byronin/Pico_Sumo_Robot/README.md

# Mini Sumo Robot with Raspberry Pi Pico 

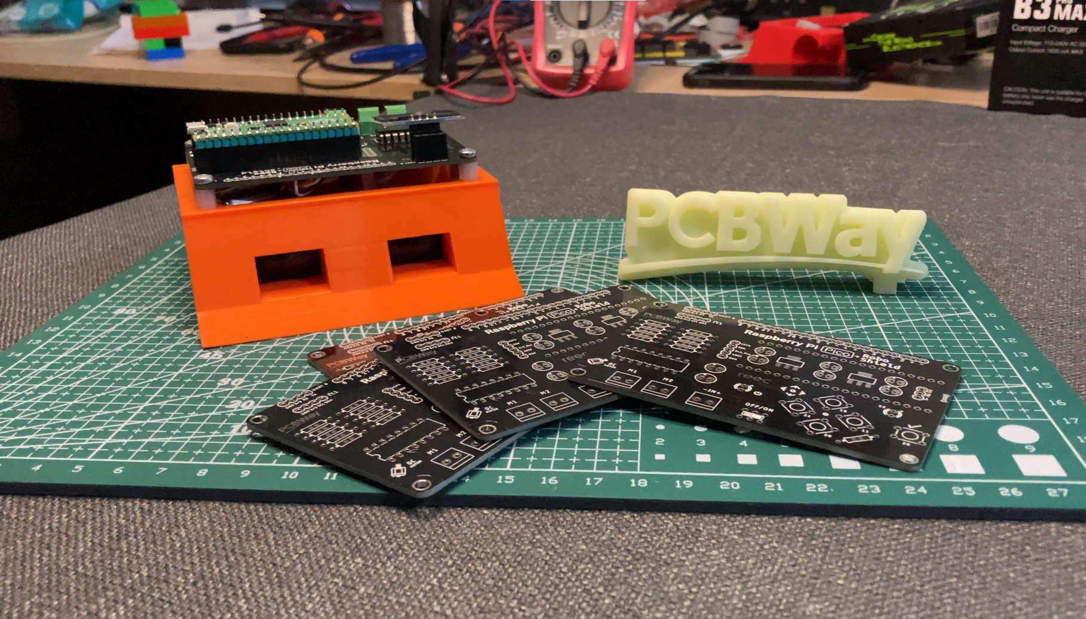
[picture p1: Hardware/Sumo2.png]


Actually, the goal of this project was not to build a mini sumo robot, but to create a robot control board that can be used with Raspberry Pi Pico. By making a mini sumo robot, I demonstrated a project that can be done with the control board. I made a small addition to the design so that everyone can easily solder the board in the workshop by choosing the preferred component shape. You can quickly and professionally manufacture this board via PCBWay.com. You can follow the necessary directions for the project below.
## Sponsor
(https://www.pcbway.com/project/shareproject/LoRa_Module_for_Raspberry_Pi_Arduino_ESP8266_Testing_LoRa_under_sea_83c3da00.html)
#### Thanks to PCBWay for handling PCB production.
<a href="https://www.pcbway.com/project/shareproject/Raspberry_Pi_Pico_Robot_Controller_Mini_Sumo_Robot_a2ead701.html">PCB from PCBWay</a>

  ## Schematic
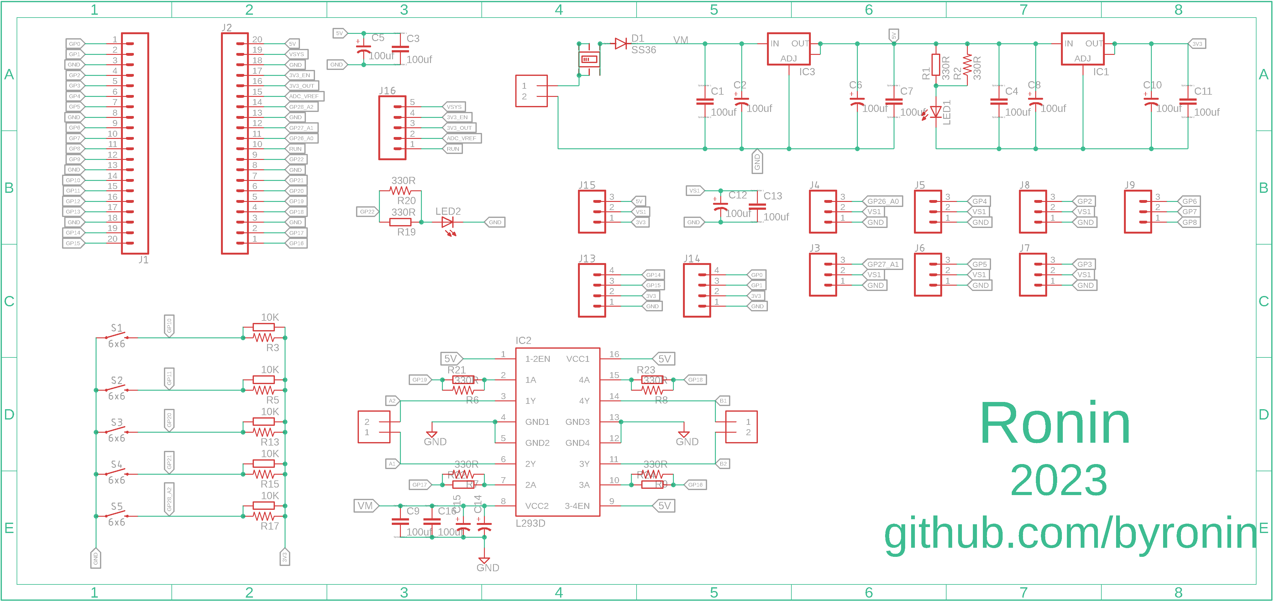
[picture p2: Hardware/Schematic.png]


## Hardware & BOM
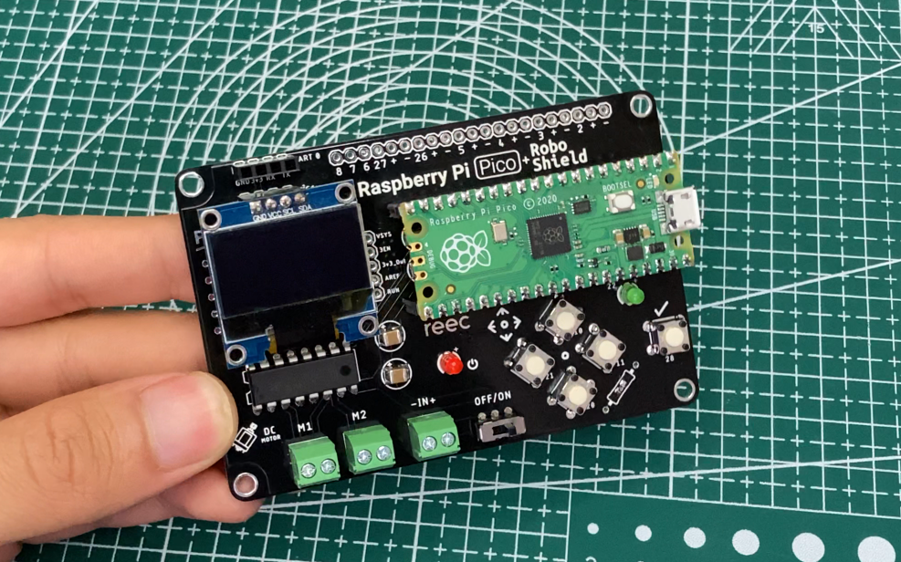
[picture p3: Hardware/Board1.png]

 This PCB Desing with Eagle PCB Desing with Eagle (https://www.autodesk.com/products/eagle/free-download "This PCB Desing with Eagle ") 
  ##### This PCB Desing with Eagle  
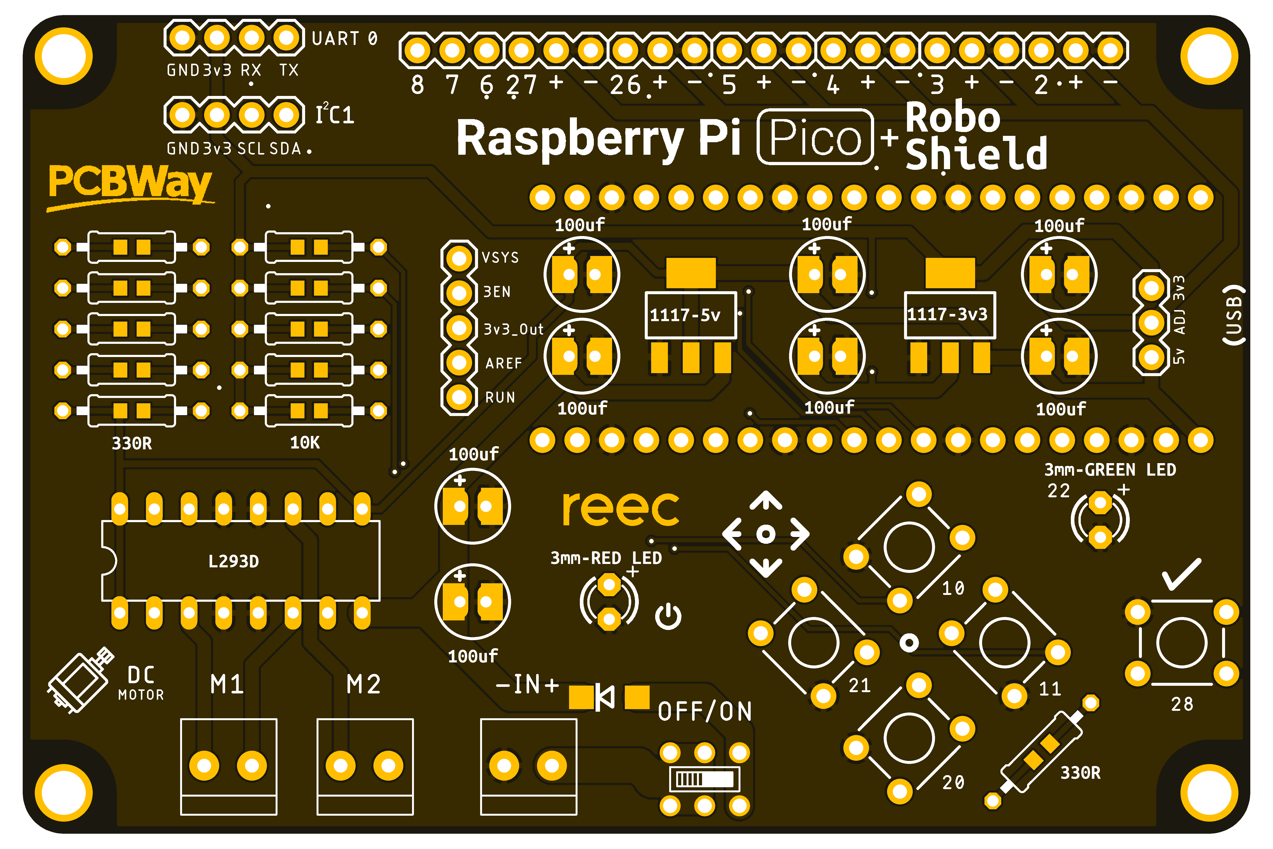
[picture p4: Hardware/PCB2.png]
  
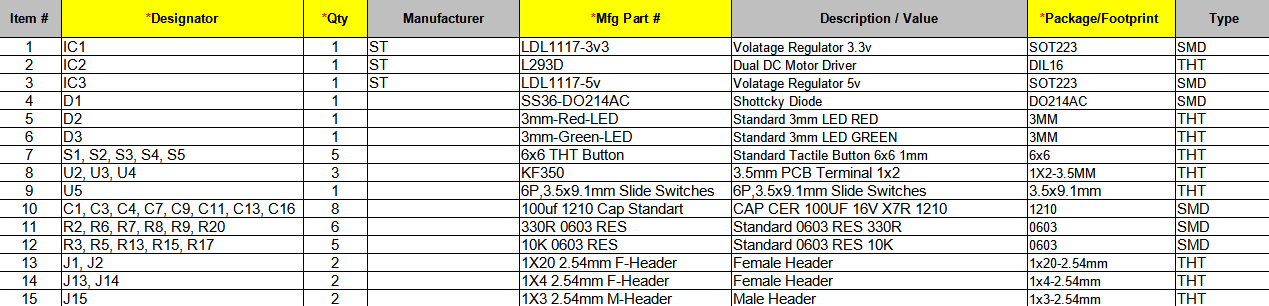
[picture p5: Hardware/bom.png]
BOM
  
## Robot Parts

|No| PCB Components  | Piece ||No| PCB Components  |Piece | 
| --- |  --- |--- |---| --- | --- |--- |
|1| [12mm 625rpm DC Motor](https://www.sumozade.com/tr/urun/force-up-6v-625-rpm-ultrapower-dc-gear-motor "12mm 625rpm DC Motor")  |  2 pcs  ||2| [2s 7.4v LiPo Battery](https://www.jsumo.com/gens-ace-300mah-74v-25c-2s1p-lipo-battery "2s 7.4v LiPo Battery") | 1 pcs |
|3| [Sumo Wheel](https://www.sumozade.com/tr/urun/spare-bond-silicone-wheel-30x23mm-pair-black "Sumo Wheel")  |  1 pcs ||4| [FS80NK-Sensor](https://tr.aliexpress.com/item/4000859937540.html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 "FS80NK-Sensor") | 2 pcs |
### 3D File
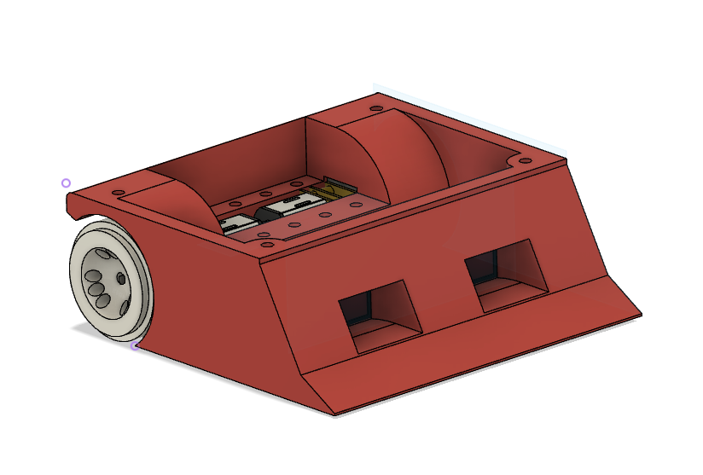
[picture p6: Robot/Chasis.png]


[Click for the files](https://www.sumozade.com/tr/urun/force-up-6v-625-rpm-ultrapower-dc-gear-motor "Click for the files")

## Software 
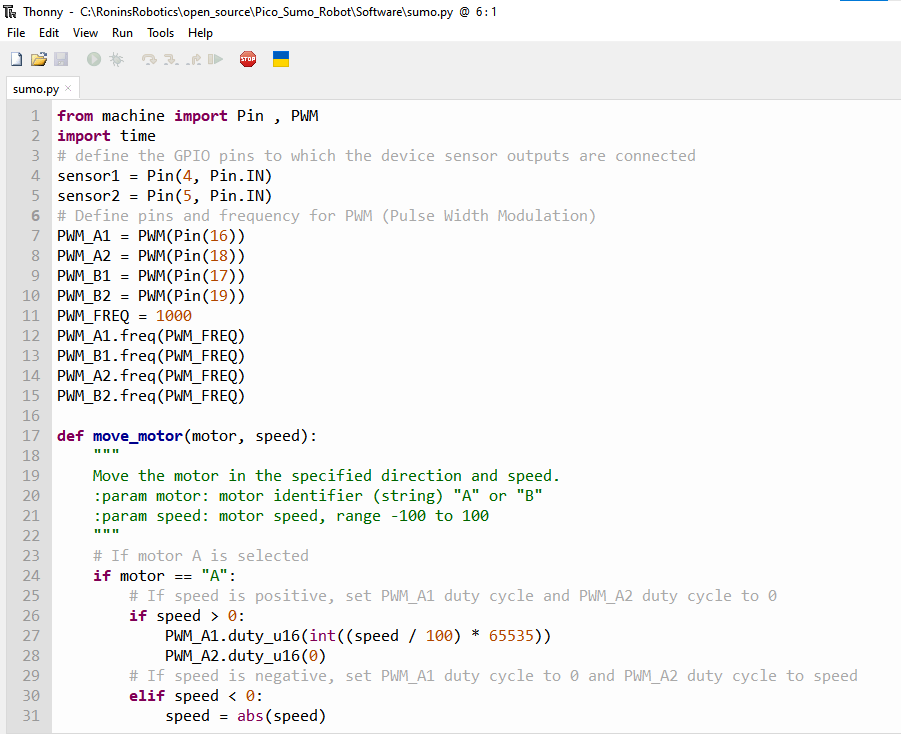
[picture p7: Hardware/Code.png]


You can code your robot on any platform that is supported by Raspberry Pi Pico. I wrote a micropython code using "Thonny IDE". You need to save the [sumo.py](https://github.com/byronin/Pico_Sumo_Robot/blob/main/Software/sumo.py "sumo.py") code as the main file on your board.
