byronin/Pico_Sumo_Robot/Hardware/Board2.png

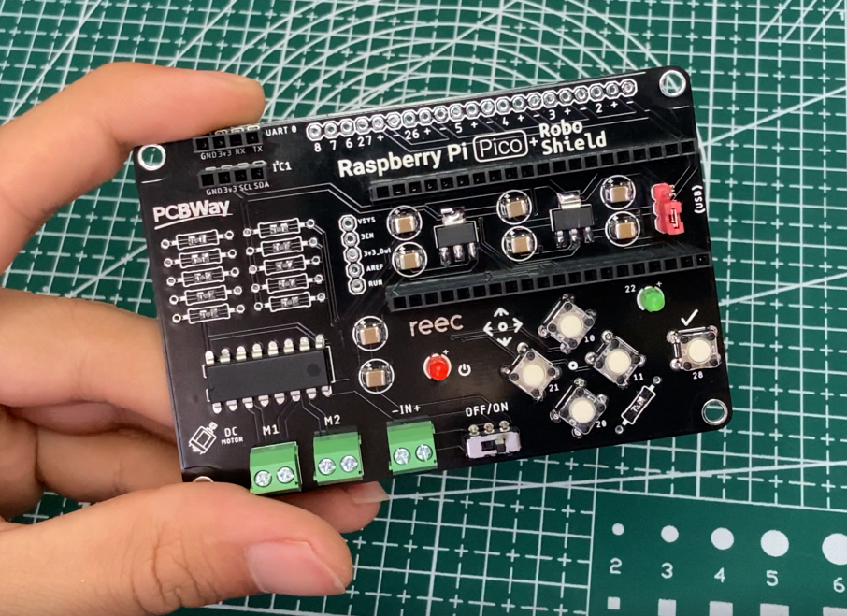
Hardware/Board2.png
