byronin/Pico_Sumo_Robot/Hardware/Board3.jpg

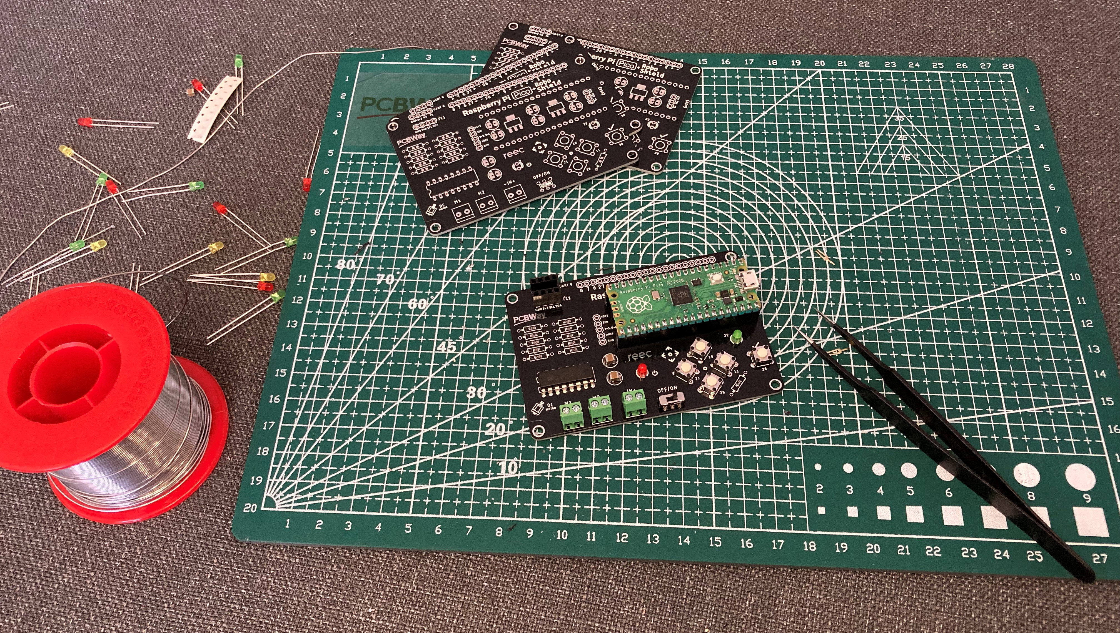
Hardware/Board3.jpg
