byronin/Pico_Sumo_Robot/Hardware/PCB1.png

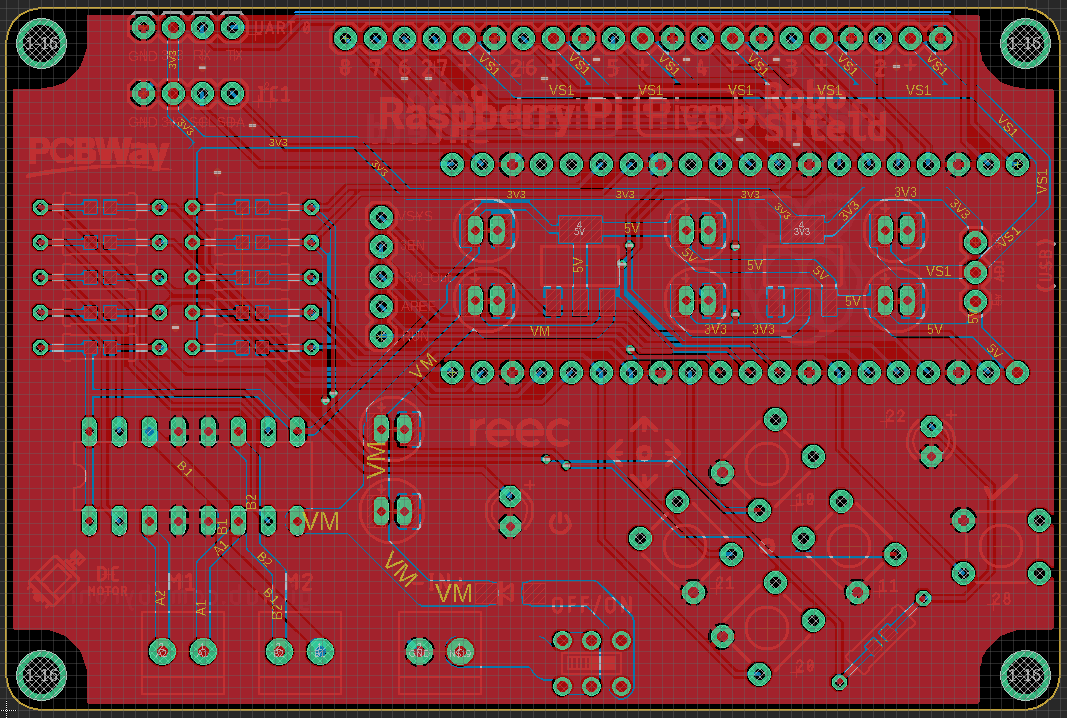
Hardware/PCB1.png
