byronin/Pico_Sumo_Robot/Hardware/Sumo1.png

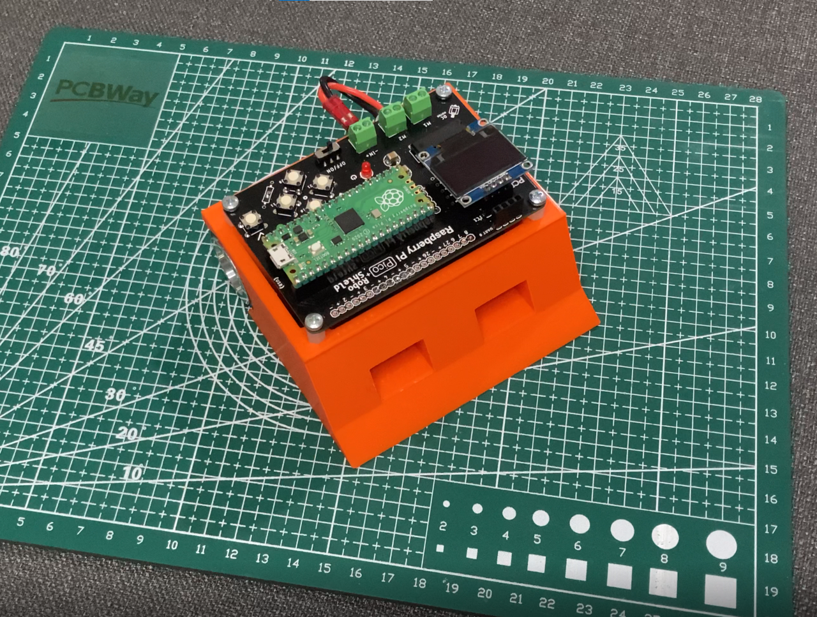
Hardware/Sumo1.png
