byronin/Pico_Sumo_Robot/Hardware/BOM.xlsx

 |  |  | Raspberry Pi Pico Robot Controller BOM
Item # | *Designator | *Qty | Manufacturer | *Mfg Part # | Description / Value | *Package/Footprint | Type | Your Instructions / Notes
1 | IC1 | 1 | ST | LDL1117-3v3 | Volatage Regulator 3.3v | SOT223 | SMD
2 | IC2 | 1 | ST | L293D | Dual DC Motor Driver | DIL16 | THT
3 | IC3 | 1 | ST | LDL1117-5v | Volatage Regulator 5v | SOT223 | SMD
4 | D1 | 1 |  | SS36-DO214AC | Shottcky Diode | DO214AC | SMD
5 | D2 | 1 |  | 3mm-Red-LED | Standard 3mm LED RED | 3MM | THT
6 | D3 | 1 |  | 3mm-Green-LED | Standard 3mm LED GREEN | 3MM | THT
7 | S1, S2, S3, S4, S5 | 5 |  | 6x6 THT Button | Standard Tactile Button 6x6 1mm | 6x6 | THT
8 | U2, U3, U4 | 3 |  | KF350 | 3.5mm PCB Terminal 1x2 | 1X2-3.5MM | THT
9 | U5 | 1 |  | 6P,3.5x9.1mm Slide Switches | 6P,3.5x9.1mm Slide Switches | 3.5x9.1mm | THT
10 | C1, C3, C4, C7, C9, C11, C13, C16 | 8 |  | 100uf 1210 Cap Standart | CAP CER 100UF 16V X7R 1210 | 1210 | SMD
11 | R2, R6, R7, R8, R9, R20 | 6 |  | 330R 0603 RES | Standard 0603 RES 330R | 0603 | SMD
12 | R3, R5, R13, R15, R17 | 5 |  | 10K 0603 RES | Standard 0603 RES 10K | 0603 | SMD
13 | J1, J2 | 2 |  | 1X20 2.54mm F-Header | Female Header | 1x20-2.54mm | THT
14 | J13, J14 | 2 |  | 1X4 2.54mm F-Header | Female Header | 1x4-2.54mm | THT
15 | J15 | 2 |  | 1X3 2.54mm M-Header | Male Header | 1x3-2.54mm | THT
Need a quick and accurante quote? Need an efficient production? Please read SMT Ordering Necessary Files & Info in 1 minute. Thank you very much! (https://www.pcbway.com/smt_ordering_guide.html)
Click for Instructions on How to Create a BOM (https://www.pcbway.com/blog/PCB_Assembly/How_to_Build_a_BOM__Bill_Of_Materials_.html)
