byronin/Pico_Sumo_Robot/Robot/chassis.stl

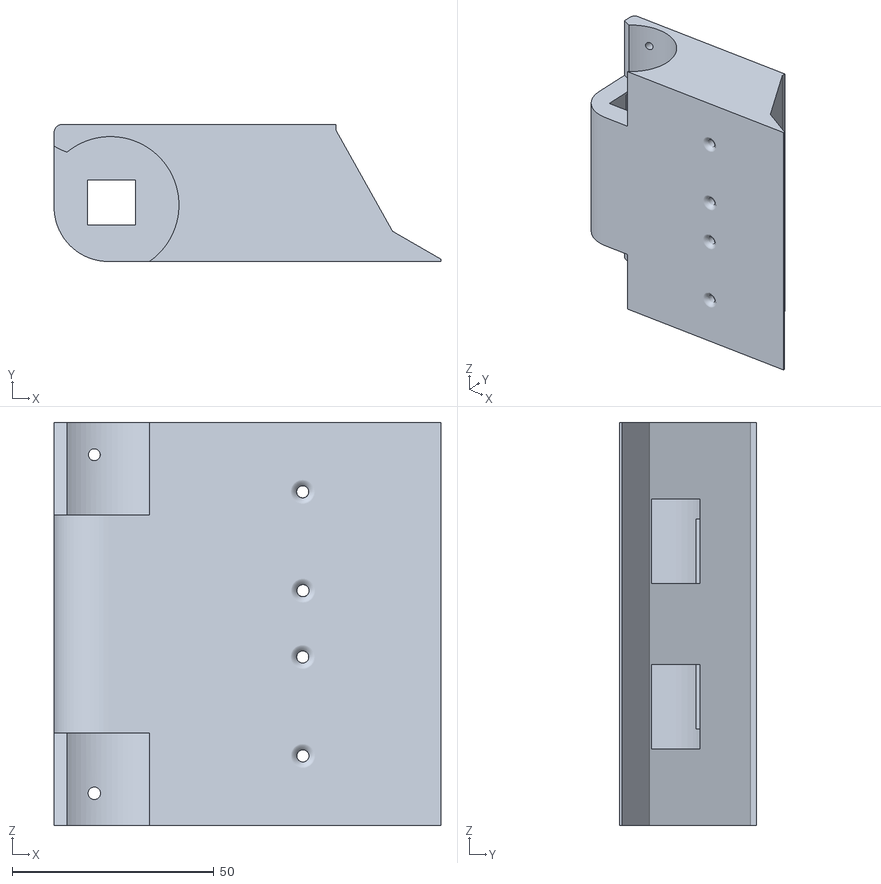
[picture p12: CAD file, 2023-03-26]
Robot/chassis.stl
96.0 x 34.0 x 100.0
