byronin/Pico_Sumo_Robot/Robot/motor_case.stl

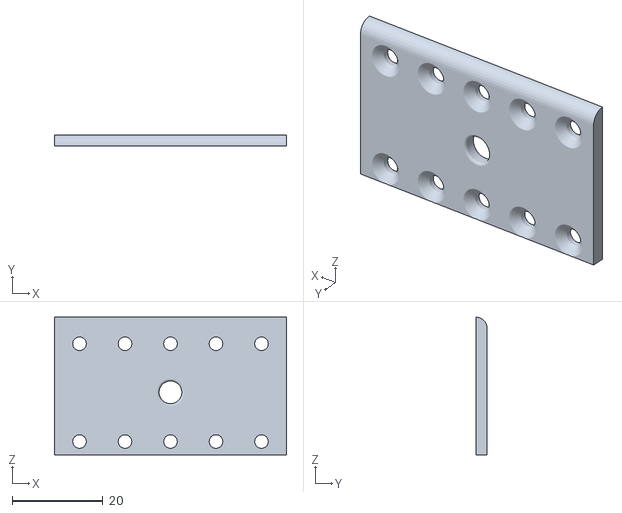
[picture p13: CAD file, 2023-03-26]
Robot/motor_case.stl
51.0 x 2.50 x 30.3
